Esmtra/The_CNC_pen_plotter/Report.pdf

# Cartesian Writing Robot

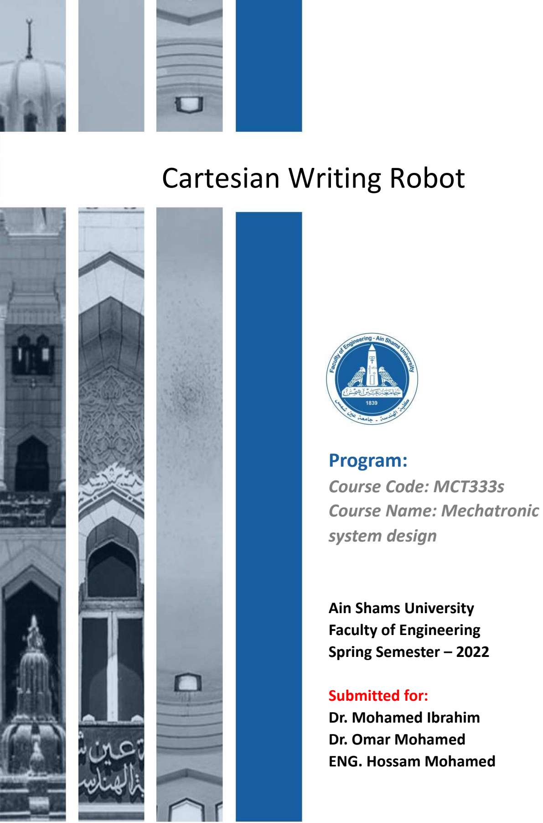
[picture p16: page 1]

SPRING SEMESTER - YEAR 2019/2020

# Program:

## Course Code: MCT333s Course Name: Mechatronic system design

## Ain Shams University Faculty of Engineering Spring Semester – 2022

## Submitted for: Dr. Mohamed Ibrahim Dr. Omar Mohamed ENG. Hossam Mohamed

2

AIN SHAMS UNIVERSITY
FACULTY OF ENGINEERING

MCT333, Mechatronics Design, FALL 2022

## Student Names:

Ashraf Mohamed AbdelSabor | 1802427
Eslam Sayed Rady | 1902236
Mohamed Hassan Mohamed | 1807742
Mohamed Hussein Adel | 1802683
Mohamed Ibrahim AbdelMoniem | 1808031
Walaa Hassan Mohamed | 1805008

3

# 1. Submission Contents

### 01: Introduction

### 02: Cad detailed design

### 03: MATLAB model and simulation

### 04: Actuator sizing

### 05: Electrical schematic and simulation

### 06: component selection

### 07: software design and framework

4

# Table of Contents

1.Table of contribution | Error! Bookmark not defined.
2.Submission Contents | 3
3.Abstract | 5
4..Intro to cartesian Robot: | 5
5.Cad detailed Design: | 7
6.MATLAB model and simulation: | 9
7.Actuator sizing by Simulink | 9
8.Actuator sizing: | 13
9.Electrical schematic and simulation: | 19
10.Component selection | 21
11.Software design and frame work | 26
12.Trials | 30

# Table of Figures

Figure 1Assembly | Error! Bookmark not defined.
Figure 2Assembly | Error! Bookmark not defined.
Figure 3Simulink simulation | Error! Bookmark not defined.
Figure 4x-axis | 9
Figure 5y-axis | 10
Figure 6z-axis | 10
Figure 7block diagram of Simulink | Error! Bookmark not defined.
Figure 8Parent Sheet | 19
Figure 9CNC Driver-X child sheet | Error! Bookmark not defined.
Figure 10Simulation | 20
Figure 11Simulation2 | Error! Bookmark not defined.
Figure 12Inkscape | 26
Figure 13UGS | Error! Bookmark not defined.
Figure 14Open loop | Error! Bookmark not defined.
Figure 15Closed Loop | Error! Bookmark not defined.
Figure 16First Trial | 30
Figure 17Second Trial | Error! Bookmark not defined.
Figure 17Second Trial | Error! Bookmark not defined.

5

# 2.Abstract

# The term “CNC” is a generic term which can be used to describe

many types of devices, this would include plotters, vinyl cutters,

# 3D printers, milling machines and others. CNC stands for Computer Numerically Controlled and basically means that the physical movements of the machine are controlled by instructions, such as co-ordinate positions that are generated using a computer

# 3. Intro to cartesian Robot:

# Cartesian coordinate geometry is an excellent method for mapping three-dimensional space in a simple, easy-to-understand numerical system. In the Cartesian system for three-dimensional space, there are three coordinate axes that are perpendicular to each other (orthogonal axes) and meet at the

origin.

The three axes are generally referred to as the x-axis, y-axis, and z-axis. Any point in three-dimensional space is represented by three numbers as (x, y, z). X represents the distance of the point from the origin along the x-axis, y is the distance from the origin along the y-axis, and z is the distance from the origin along the

z-axis.

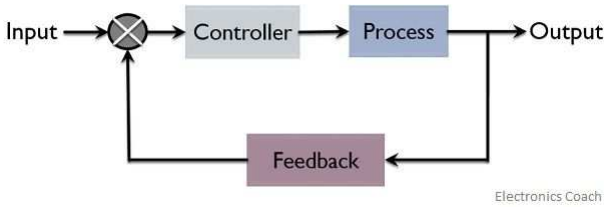
[picture p17: figure]

6

Cartesian robots have an overhead structure that controls the motion in the horizontal plane and a robotic arm that actuates motion vertically. They can be designed to move in x-y axes or x-y-z axes. The robotic arm is placed on the scaffolding and can be moved in the horizontal plane. The robotic arm has an effector or machine tool attached to the end of the arm which is a pen

# closed loop control system

# A closed loop control system is a mechanical or electronic device that automatically regulates a system to maintain a

desired state or set point without human interaction.

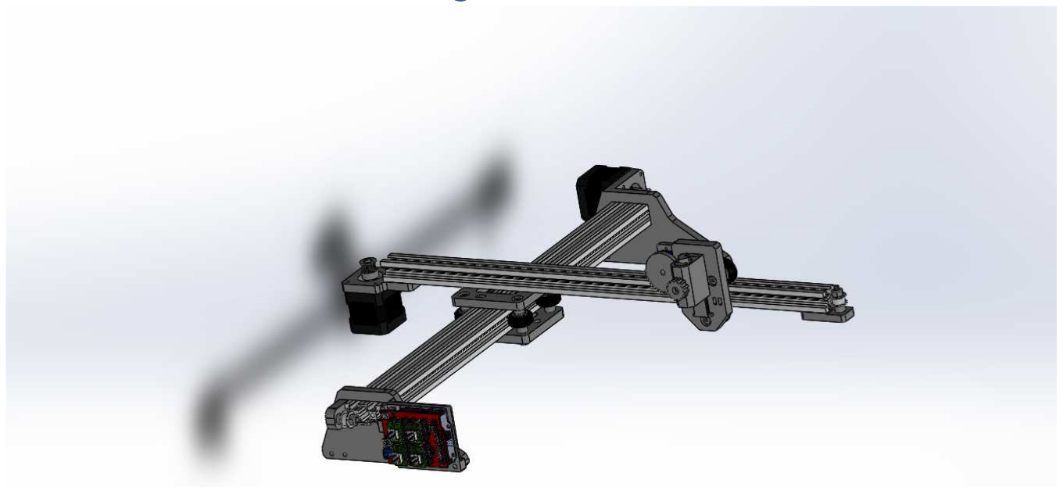
[picture p18: figure]

7

# 4. Cad detailed Design:

Figure 1Assembly

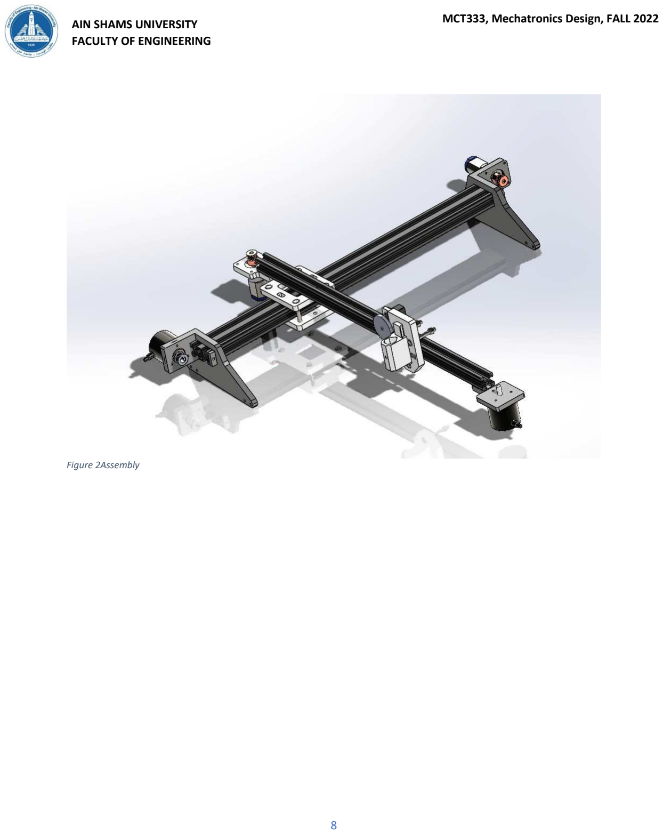
[picture p19: page 8]

8

Figure 2Assembly

# 5.MATLAB model and simulation:

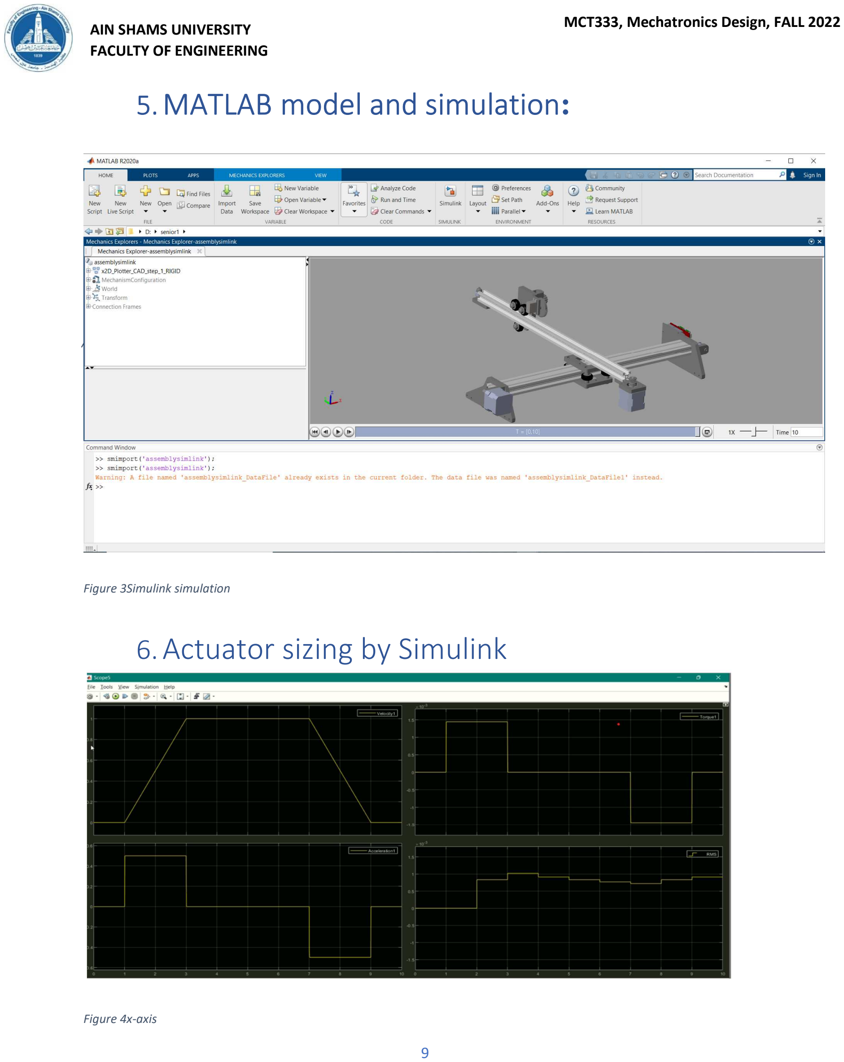
[picture p20: page 9]

9

Assembly2

# 6.Actuator sizing by Simulink

Figure 4x-axis

Figure 3Simulink simulation

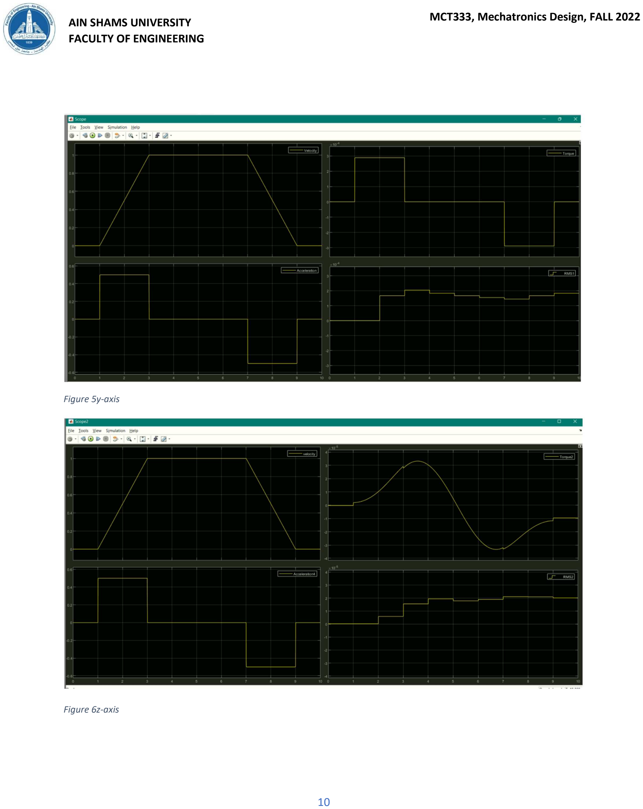
[picture p21: page 10]

10

Figure 5y-axis

Figure 6z-axis

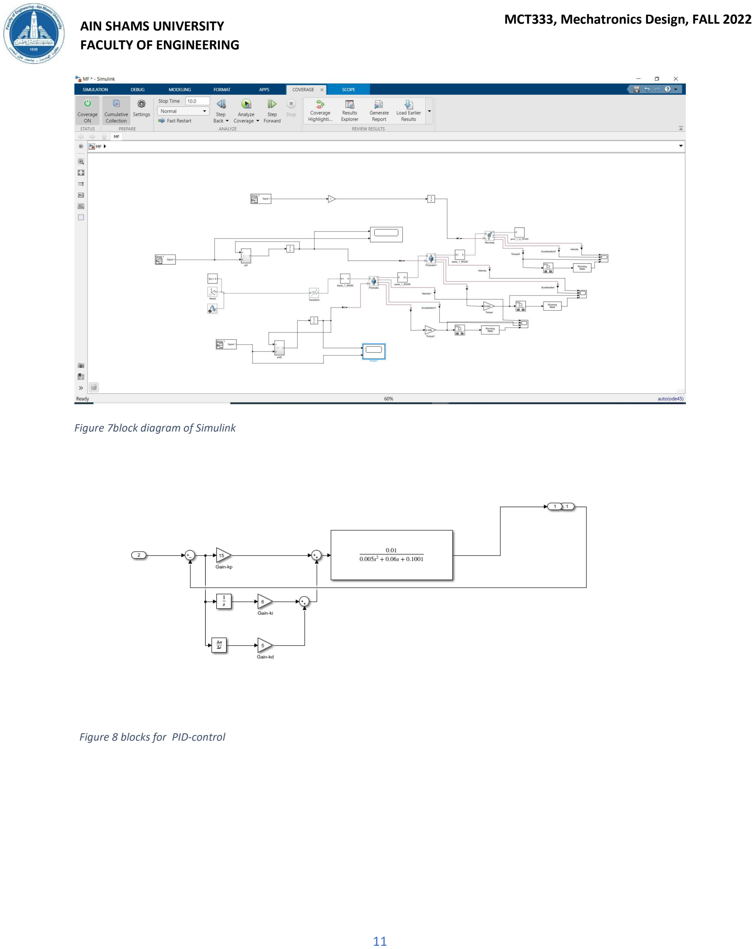
[picture p22: page 11]

11

Figure 8 blocks for PID-control

Figure 7block diagram of Simulink

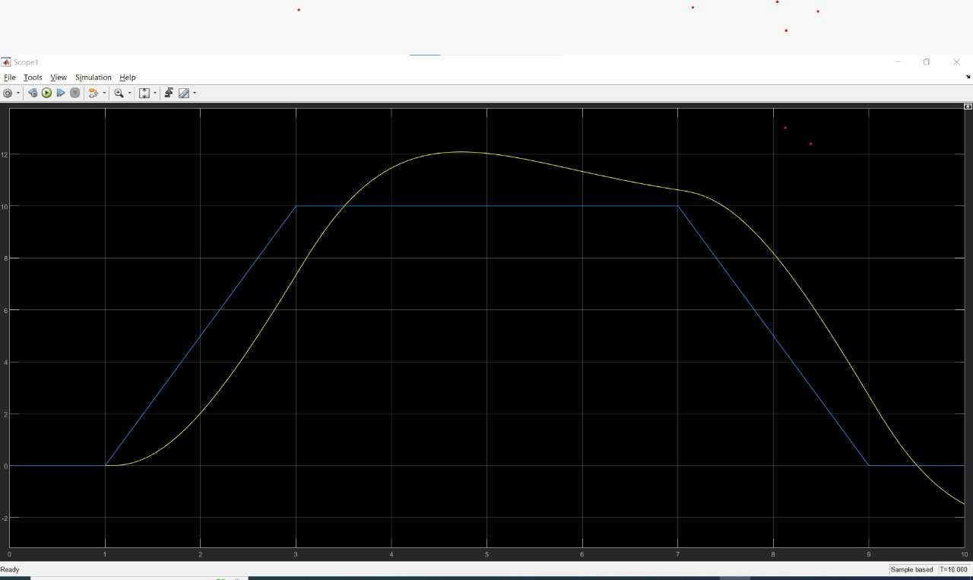
[picture p23: figure]

12

Figure 9 PID graph

13

# 8.Actuator sizing:

# Belt drive X

## For pully inertia:

d-

=

# = 14.11 mm = D

r =

5
2

= 2.5mm

# made of aluminum → ∴ ρ = 2700 !"

# Volume = V = %

&

# h (D − d

)
∴ V =

π
4

∗ (16 ∗ 10./0 ∗ 1(14.11 ∗ 10./0

− (5 ∗ 10./0

2

V = 2.188 *10.m/
→ m = ρ V = 2700 ∗ 2.188 *10. = 5.9 *10./ kg .

## Assume we neglect the mass of belt

∴ 3 =

1
2

4 5 =

1
2

∗ 5.9 ∗ 10./ ∗ 7 8

9:
2

;

+ 5=>>?@

A
= 0.5 ∗ 5.9 ∗ 10./ ∗ BC14.11 ∗ 10./ 2

D

+ (2.5 ∗ 10./0

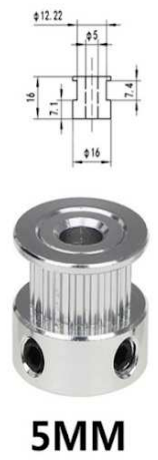
[picture p24: figure]

# E = 1.65 ∗ 10.FGH. 4 2 motors → I JKLLMNO , QRS OJMMS TQUVW = X ∴ VMYY. = I ∗ V = Z. Z[\ ∗ X[.] ^_. `I

# as V`WUWT =

X
X

# VMYY. = Z. Z[\ ∗ X[.] ^_. `I

## - For motor: Inertia is equal to 5.4 * 10.GH. 4

# 3abacd = 5.4 ∗ 10. + 3.305 ∗ 10.F = 5.73 ∗ 10.GH. 4

14

# fghgijkl = ∑ n → X

## *Assuming that writing Speed (end effector speed)

Let o:cp = 250 mm/s ,

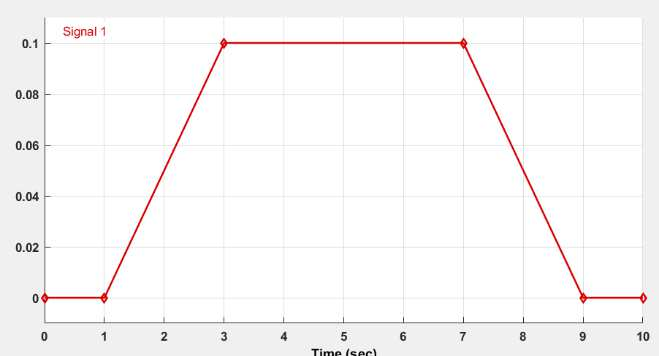
[picture p25: figure]

# ∴ qr:cp =

s
@

=

tu

= 40.916 5v9/x

## Assume that the height of a letter is 2 cm

## and max Velocity is 200 mm/s ∴ the time could be taken = ∗ uyz

u.t
= 0.08 s

# Assume → {c = {@ = {| = 0.08 x

∴ ql =

# ~rÄÅ

a

= 511.45 5v9/x

# ÇÉ@=Ña=b> = ÖÉ@=Ña=b> ∗ 5 = Ü4H ∗ 5 =0.00578 Nm

## From (1) → Ç: − ÇÉ@=Ña=b> = ( 3abacd.0 ∗ ql =0.00293

# ∴ Ç: = 8.71 ∗ 10./ N.m Ç@:á = à

â ä

z

(a0 |a

# ãåçåéè

ê

# äåçåéè

=1.77 ∗ 10./ N.m

# Çc = 0.00871N.m

Ç@ = 0.00578 ë. 4

## Ç| =0.00285 N.m

# Ç:bab@

t

8.71

5.78

2.85

15

# Belt drive Y

# For pully inertia:

# In (Y)

d-

=

# = 14.11 mm = D

r =

5
2

= 2.5mm

# made of aluminum → ∴ ρ = 2700 !"

# Volume = V = %

&

# h (D − d

)
∴ V =

π
4

∗ (16 ∗ 10./0 ∗ 1(14.11 ∗ 10./0 − (5 ∗ 10./0

2

V = 2.188 *10.m/
→ m = ρ V = 2700 ∗ 2.188 *10. = 5.9 *10./ kg .

## Assume we neglect the mass of belt

∴ 3 =

1
2

4 5 =

1
2

∗ 5.9 ∗ 10./ ∗ 7 89:
2

;

+ 5=>>?@

A
= 0.5 ∗ 5.9 ∗ 10./ ∗ BC

14.11 ∗ 10./
2

D

+ (2.5 ∗ 10./0

E

# = 1.65 ∗ 10.FGH. 4 2 motors → 2 íìîîïñx , vó9 xíïï9 5v{3ò = 1 ∴ 3?ÉÉ. = 2 ∗ 3 = 3.305 ∗ 10.F GH. 4

1
2

4ô =

1
2

# 3?ÉÉö

# →∴ 3?ÉÉ = 45 = 9.557 ∗ 10.GH. 4

16

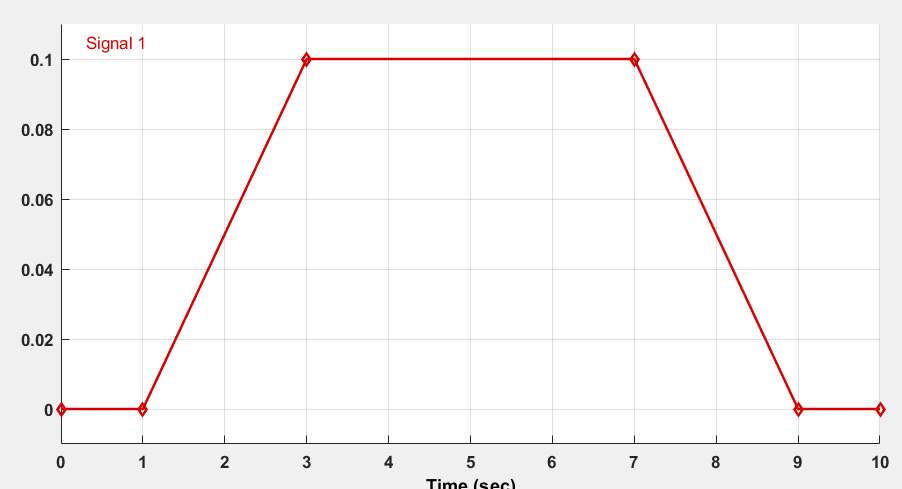
[picture p26: figure]

t

# as 3:bab@ =

# (3.305 ∗ 10.F + 9.557 ∗ 10.0 = 9.887 ∗ 10. GH. 4

## - For motor: Inertia is equal to 5.4 * 10.GH. 4

# 3abacd = 5.4 ∗ 10. + 9.887 ∗ 10. = 1.5 ∗ 10.tGH. 4 iõúõùûθl = ∑ T → 1

## *Assuming that writing Speed (end effector speed)

Let o:cp = 250 mm/s ,

# ∴ qr:cp =

s
@

=

tu

= 40.916 5v9/x

## Assume that the height of a letter is 2 cm

## and max Velocity is 200 mm/s ∴ the time could be taken = ∗ uyz

u.t
= 0.08 s

# Assume → {c = {@ = {| = 0.08 x

∴ ql =

# ~rÄÅ

a

= 511.45 5v9/x

# ÇÉ@=Ña=b> = ÖÉ@=Ña=b> ∗ 5 = Ü4H ∗ 5 =0.00578 Nm

# Ç° = Ö° ∗ 5 = 0.00936 ë. 4

# From (1) → Ç: − ÇÉ@=Ña=b> − Ç° = ( 3abacd.0 ∗ ql =0.00293

# ∴ Ç: = 0.0116 N.m Çc = 0.0116N.m

Ç@ = 0.01807 ë. 4

## Ç| =0.0122 N.m

# Ç:bab@

0.0116

0.0180

0.0122

17

# Rack and Pinion:

# ¢?ÉÉö:

=

¢£.ö:

+

4ô@
¢?ÉÉ =

§•.
¶z +

:ßz
¶z

# 5v®G vó9 í3ó3òó ℎvx xv4ï í5ò™3îï → ∴ ë = ¶´

¶z

= 1
¢£ =

45 = 0.5 ∗ 0.008 ∗ (2.4 ∗ 10./0 = 2.3 ∗ 10.¨GH. 4

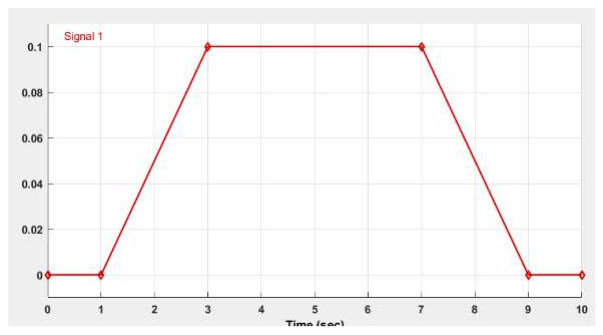
[picture p27: figure]

∴

:ßz
¶z =

# u.ut/∗.&∗uy#Æ

z

= 3.053 ∗ 10.F

# ∴ ¢?ÉÉ = 3.28 ∗ 10.FGH. 4 vxxì4ï

§

# §èØØ

# = 1 ∴ ¢abacd = 6.566 ∗ 10.F GH. 4

## Finding max. speed

# assume {c = {@ = {| = 30 4x

## Assume qabacd = °

# qabacd = q:cp

r ±

# aÄa²a³

¥

# ∴ q:cp

# r = 52.35 5v9/ sec

qc

l =
~ÄÅ

r
aÄ

=

t./t

# /u∗uy# = 1745 5v9/xï®

q@

# l = 0 , q| l =

.~ÄÅ

r
a³

# = −1745 5v9/xï® ∴ Ç:i = ¢abacd ∗ q l = 6.566 ∗ 10.F ∗ 1745 = 1.148 ∗ 10./ ∴ Ç:| = ¢abacd ∗ q l = 6.566 ∗ 10.F ∗ 1745 = −1.148 ∗ 10./

∴ Ç: = 0.0146 ∗ 1.25 = 0.0186 ë. 4

# Ç:bab@

t

1.148

-1.148

18

Ç@:á
= à

(0.01480

∗ 30 ∗ 10./ + (−0.01480
∗ 30 ∗ 10./

# 150 ∗ 10./ vxxì4ï {|°

= 60 4x

# Ç@:á = 0.0094 ë4 ∗ 1.25 = 0.0118

# 9.Electrical schematic and simulation:

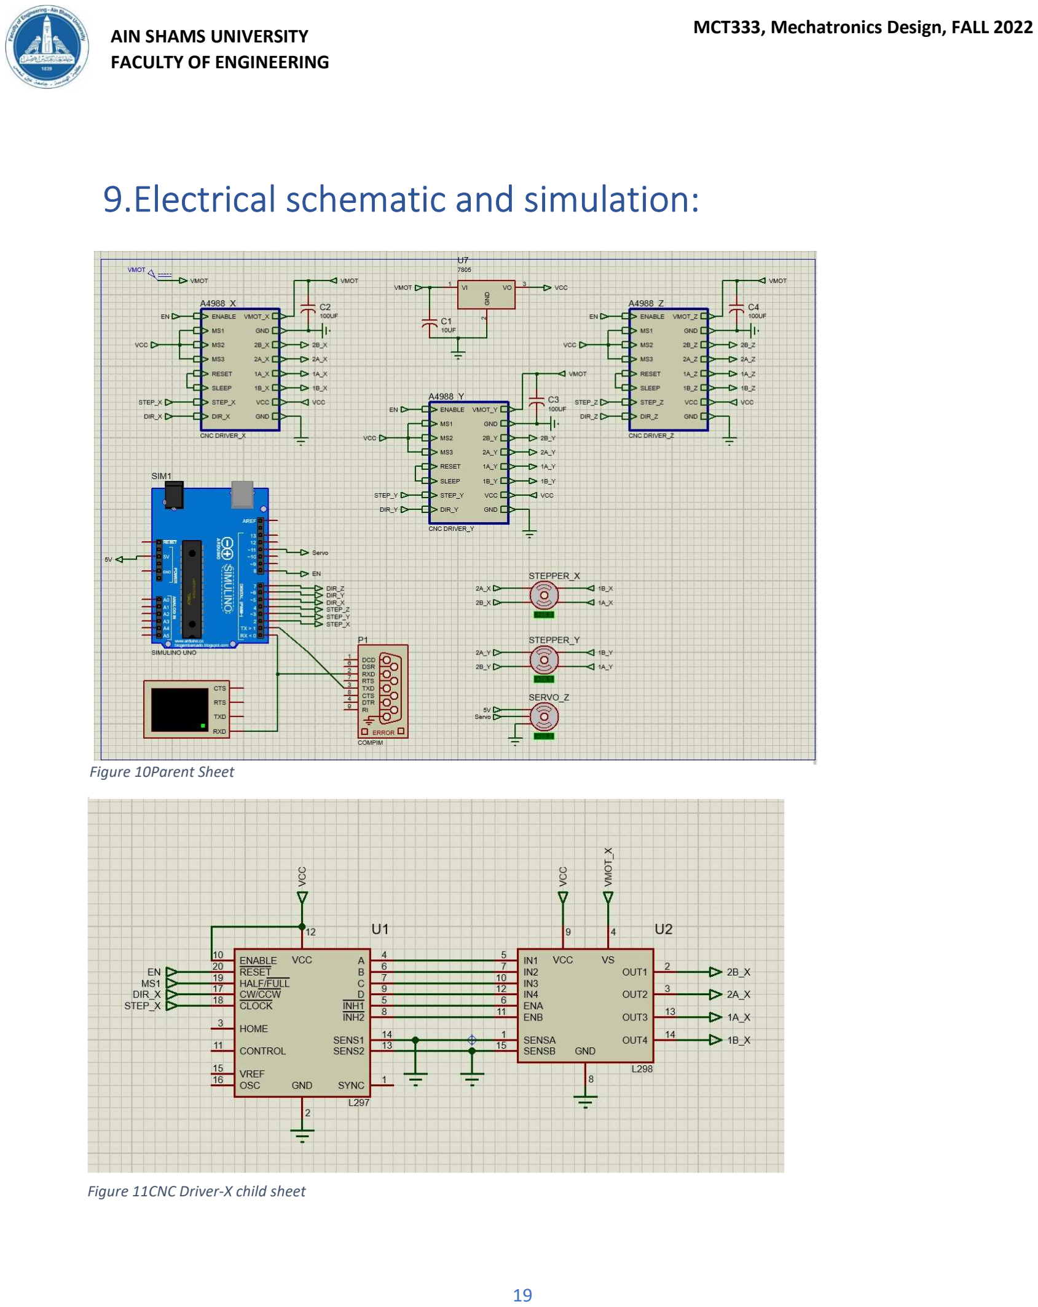
[picture p28: page 19]

19

Figure 10Parent Sheet

Figure 11CNC Driver-X child sheet

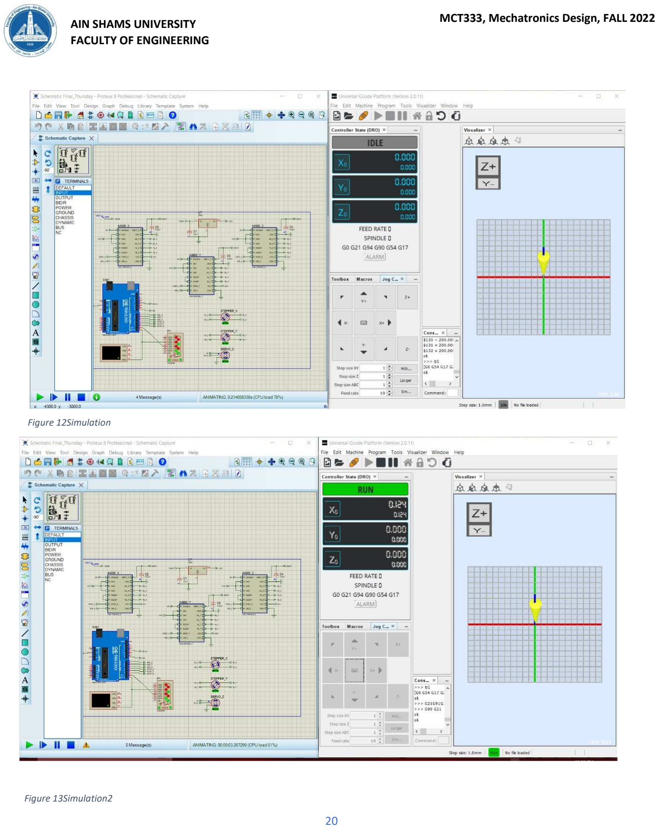
[picture p29: page 20]

20

Figure 12Simulation

Figure 13Simulation2

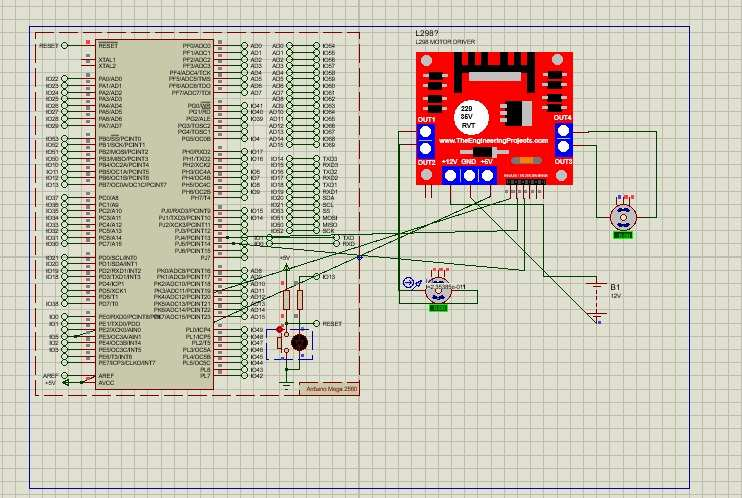
[picture p30: figure]

21

# 10.Component selection

components | Reason for selection | Specification

22

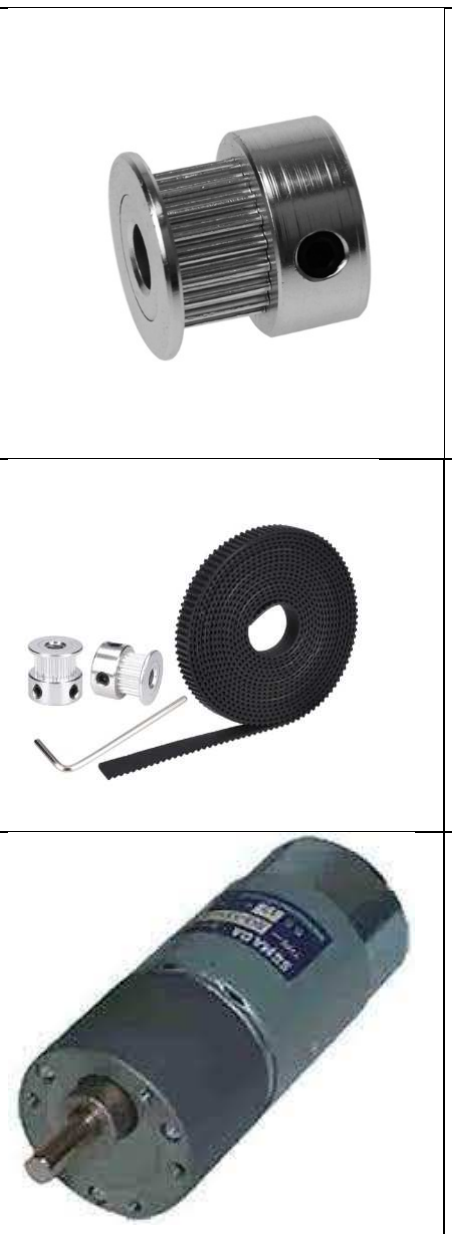
[picture p31: figure]

GT2 Bore 5mm 20 Teeth Timing Aluminum Pulley Fit GT2-6mm Open Timing Belt | Changing the direction of forces and easy to moving slider by using belt | • Color: silver • Tooth number: 20 • Tooth pitch: 2mm • Bore diameter: 5mm • Flange: double • Tooth width: 7mm ( Very Suitable and good for 6mm synchronous belt )
Meters GT2-6mm Open Timing Belt | Translate rotational motion of stepper to linear motion by cart | • Color: black • Pitch: 2mm • Width: 6mm • Material: fiber reinforced rubber
DC Geared Motor 50r/min , 0.62 N.m 2.9 Watt | geared DC Motor has a gear assembly attached to the motor. The speed of motor is counted in terms of rotations of the shaft per minute and is termed as RPM . The gear assembly helps in increasing the torque and reducing the speed | Rated Voltage: 12Vdc No Load Current: 140mA No Load Speed: 50 r/min Load Torque Current (With Load): 800mA Load Torque Speed (With Load): 36 r/min Torque: 6.3 Kgf.cm (0.62 N.m) Output Power: 2.3 W Stall Current: 3000mA Motor Weight: 350~400 gm
C-Beam Linear Rail | C-Beam linear rail is the ultimate solution combining both linear motion and a modular, structural framing system. It's lightweight yet rigid and provides an smooth track for precise motion. It is compatible with all out standard V-slot parts and accessories. | Material: 6063 T-5 Aluminum.

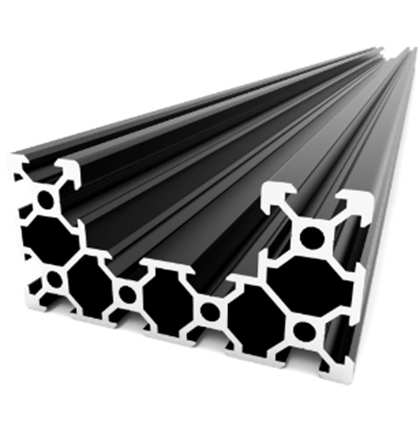
[picture p32: figure]

23

3d printing parts | Provide housing for the robot | Material: PLA Density 1.2g/cm2 Fillin: 50%

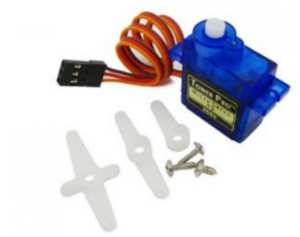
[picture p33: figure]

Servo motor | Hold pin and give direction in z axis

24

Metal V-Groove Bearing Kit | These are specialized metal bearings that are used in linear motion systems. The v-groove bearings generally ride on our rail | (2) Ball Bearings - 625 2RS (1) OpenBuilds Dual V Wheel - Metal (5mm Bore) (1) 5mm Precision Shim (1) 1/4" Aluminum Spacer (1) M5 * 25mm Low Profile Screw (1) Lock Nut with Nylon Insert
DC motor shield | the L293D is a dual-channel H-Bridge motor driver capable of driving a pair of DC motors or single stepper motor. As the shield comes with two L293D motor driver chipsets, that means it can individually drive up to four DC motors making it ideal for building four-wheel robot platforms | HiLetgo L293D DC Motor Drive Shield Stepper Motor Drive Shield Expansion Board for Arduino Duemilanove Raspberry Pi

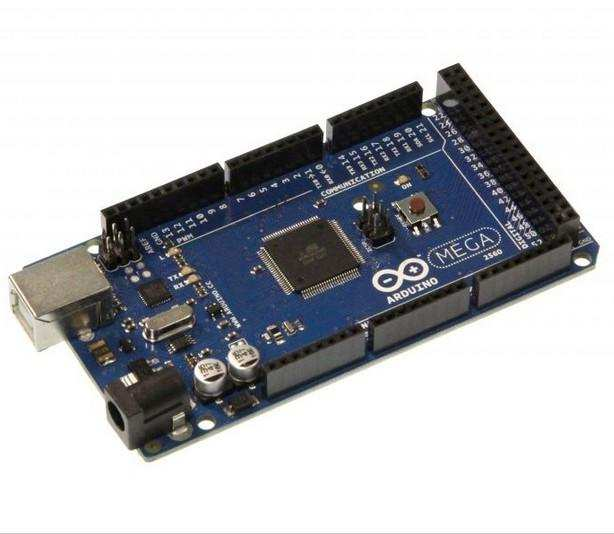
[picture p34: figure]

## Arduino

The Arduino Mega is a
microcontroller board based on the ATmega2560. It has
54 digital input/output pins (of which 15 can be used as PWM outputs), 16 analog
inputs, 4 UARTs (hardware
serial ports), a 16 MHz
crystal oscillator, a USB
connection, a power jack, an ICSP header, and a reset
button. It contains
everything needed to
support the microcontroller; simply connect it to a
computer with a USB cable
or power it with a AC-to-DC adapter or battery to get started.

## Arduino mega

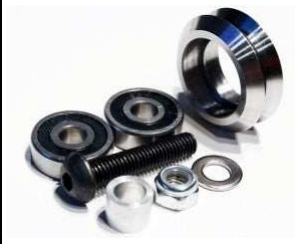
[picture p35: figure]
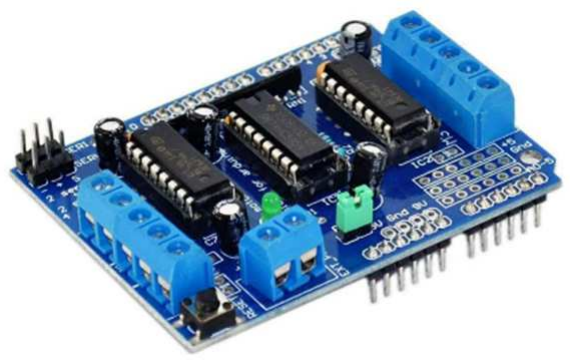
[picture p36: figure]

25

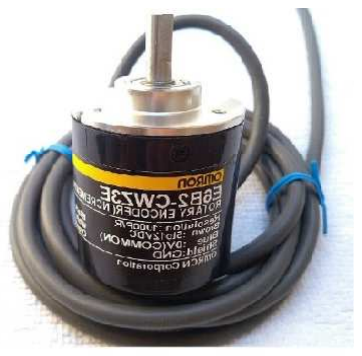
[picture p37: figure]

## Encoder

## an encoder is a sensing device that provides feedback. Encoders convert motion to an electrical signal that can be read by some type of control device in a

motion control system.

## The encoder sends a feedback signal that can be used to determine

position, count, speed,

## or direction. A control device can use this information to send a command for a

particular function.

## Rotary Encoder E6B2-CWZ3E (1000 P/R)

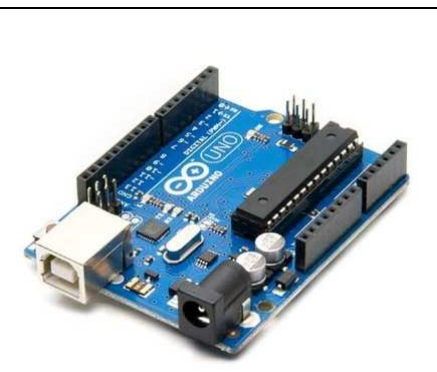
[picture p38: figure]

Arduino | Arduino is an open source hardware and software c ompany, project, and user community that designs and manufactures single board microcontrollers and mi crocontroller kits for building digital devices. | UNO

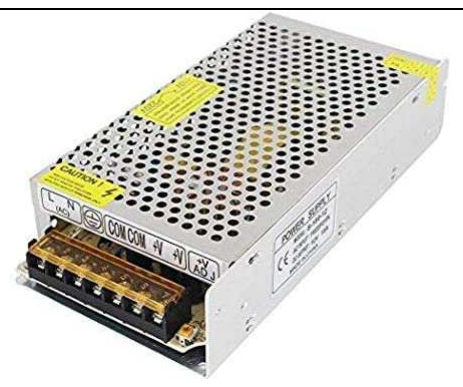
[picture p39: figure]

Power supply | power supply is an electronic circuit that converts the voltage of an alternating current (AC) into a direct current (DC) voltage. It is basically consisting of the following elements: transformer, rectifier, filter and regulator circuits. | 12 V , 5 A

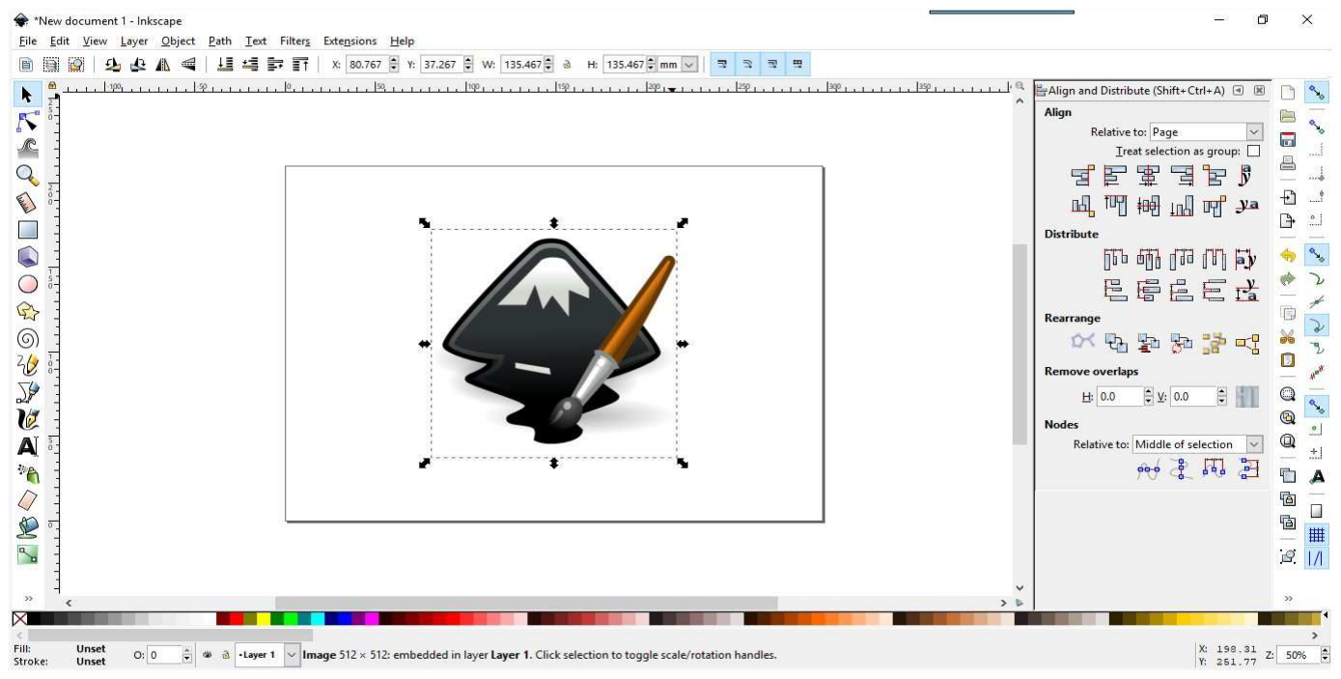
[picture p40: figure]

26

# 11.Software design and frame work

# First: Open loop

# In this project we will use 3 main open sources software programs:

# 1)Inkscape: it’s our HMI. used to convert the image needed to be drawn into path and then creates GCODE file to be sent to

Arduino.

Figure 14Inkscape

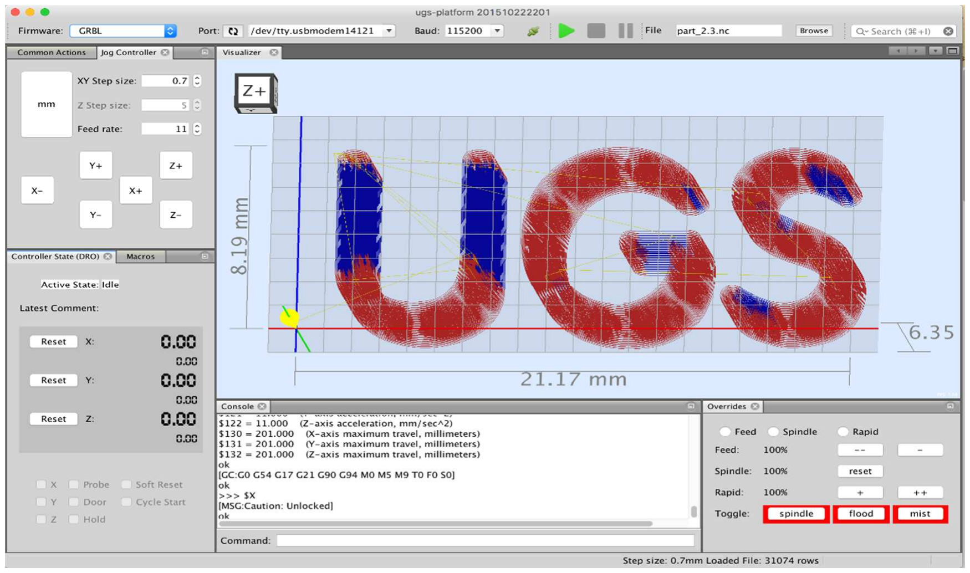
[picture p41: figure]

27

## Universal G-code sender (UGS): it’s the communication

# between our machine and computer, it has advantages of like more oversight of the machine and a real time view of the

toolpath.

# 2) GRBL: it’s the main software running on Arduino that converts

G-code into electrical signals to motor drivers (CNC shield).

## Run GRBL on Arduino:

## download the GRBL library and extract it in the Arduino's library folder. now open Arduino ide and open GRBLMAIN in example sketches, and upload "GRBL to Arduino Sketch" to your Arduino UNO board. and that's it. you have uploaded GRBL to your Arduino board

Figure 15UGS

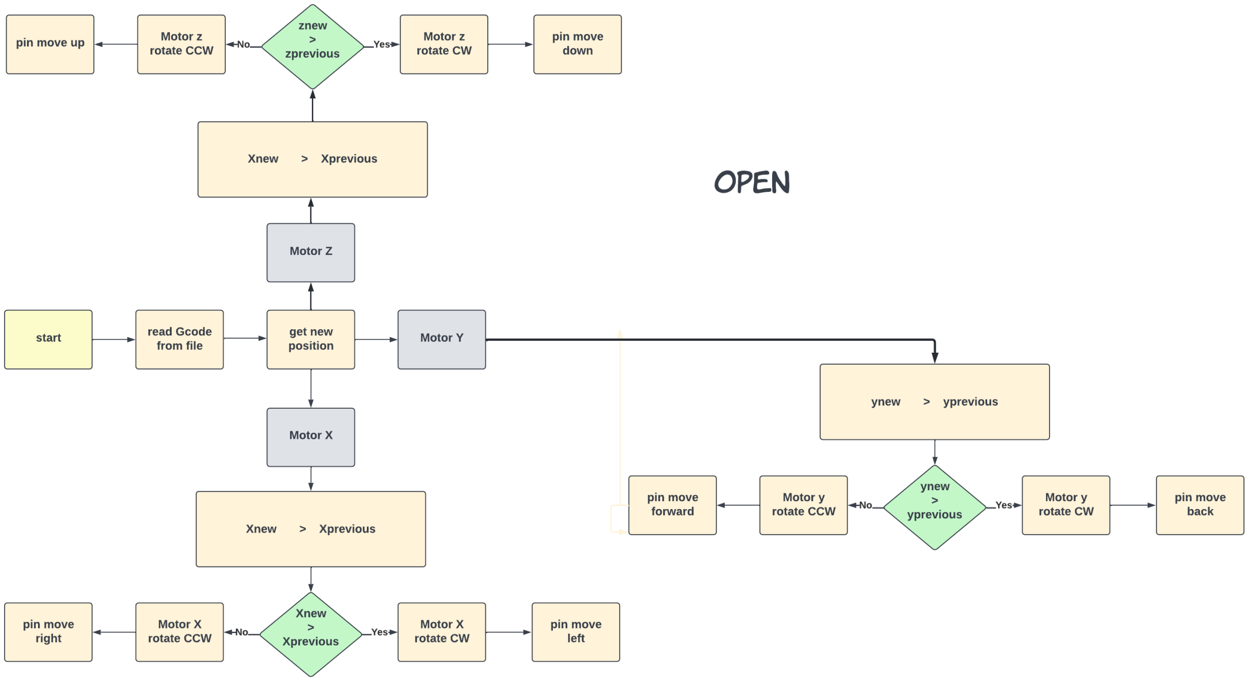
[picture p42: figure]

28

# 3)GRBL-Plotter

GRBL-Plotter is a graphic converter and gcode sender for all purposes.

## The main focus is on the post-processing of vector graphics, the specialty is the preparation of the generated Gcode, which is based on properties of the imported graphics, such as Layer, pen color or pen thickness

# Flowchart for open loop

Figure 16Open loop

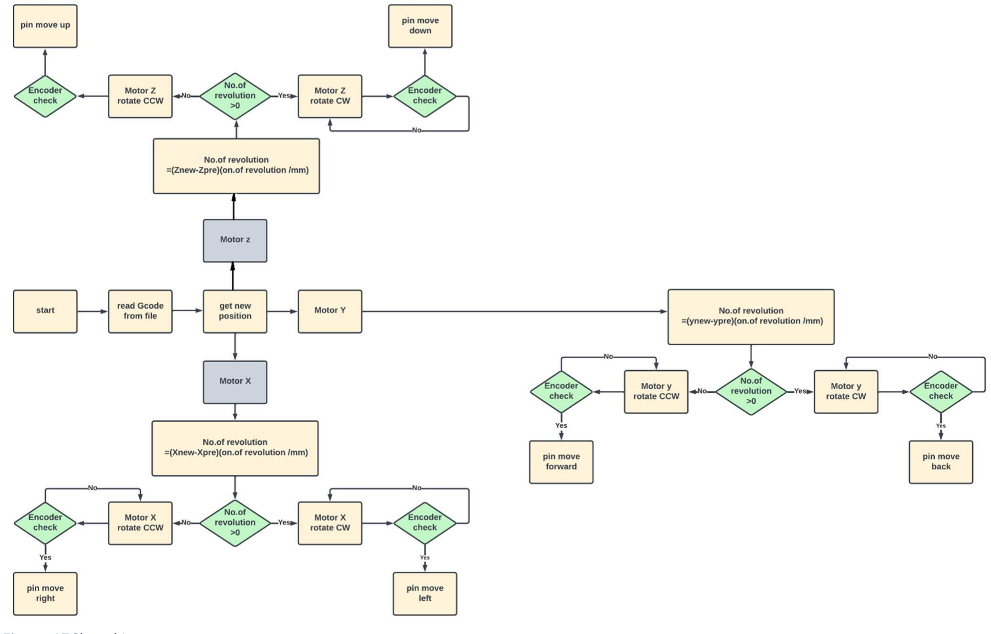
[picture p43: figure]

29

# Second: closed loop

in closed loop we will control dc motors using PID and encoders,

# so we will use only Inkscape to get GCODE from, and universal G-code sender to send to Arduino. then we code Arduino file and

make it reads the new position of each axis from this G-code file,

# then calculate the number of Rotation needed to be rotated by each

# axis from this equation ·>?° − ·£@?Æ ¸ (óì4¹ï5 ò™ 5ò{v{3òó /

440

# Flowchart for closed loop

Figure 17Closed Loop

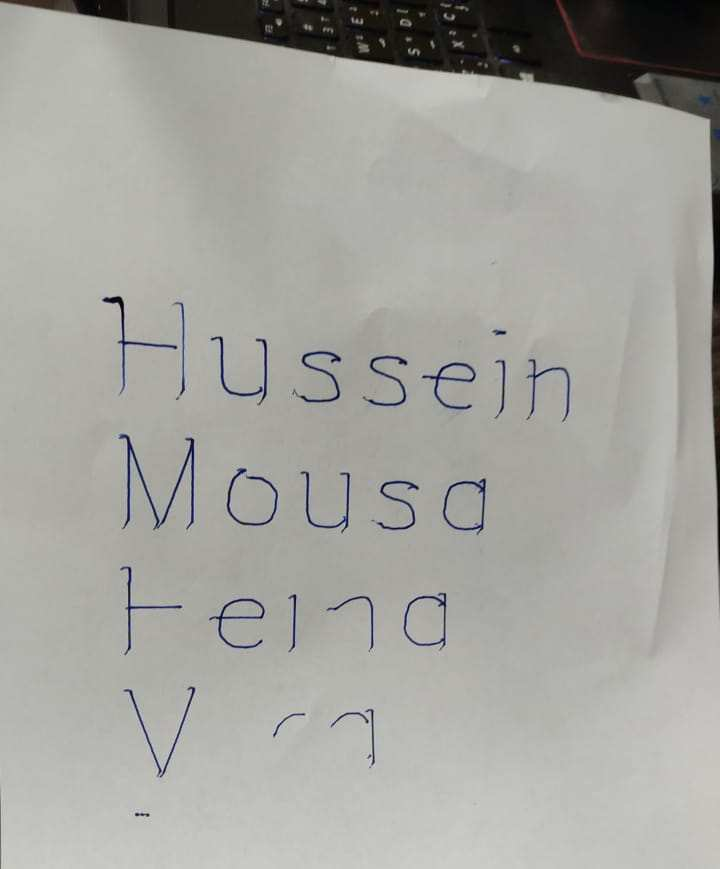
[picture p44: figure]

30

# 12.Trials

Figure 18First Trial

## Servo doesn’t work

## Reason: because Pinion broken

## Solution: we printed Pinion

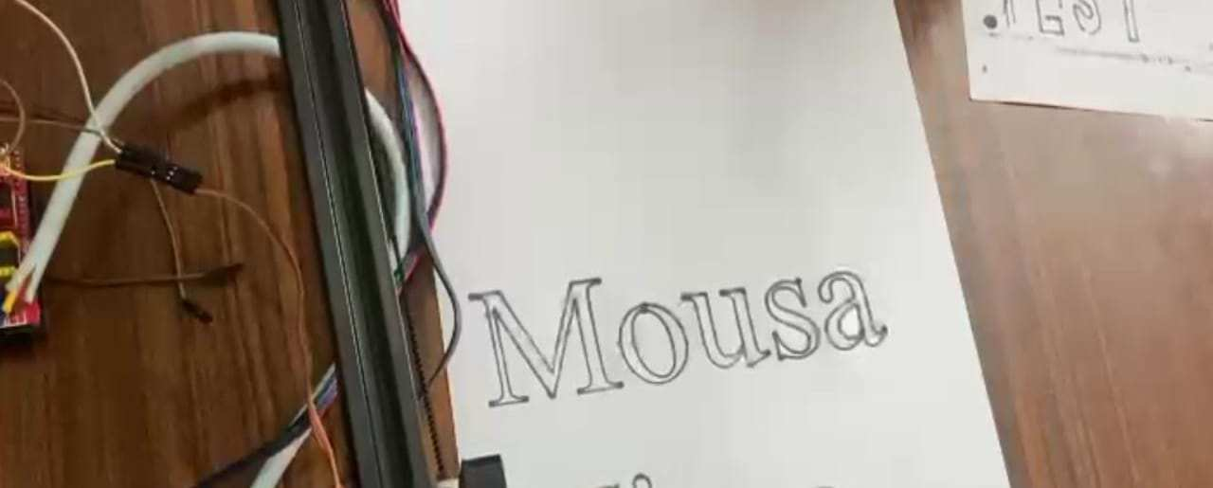
[picture p45: figure]

31

Figure17Second Trial

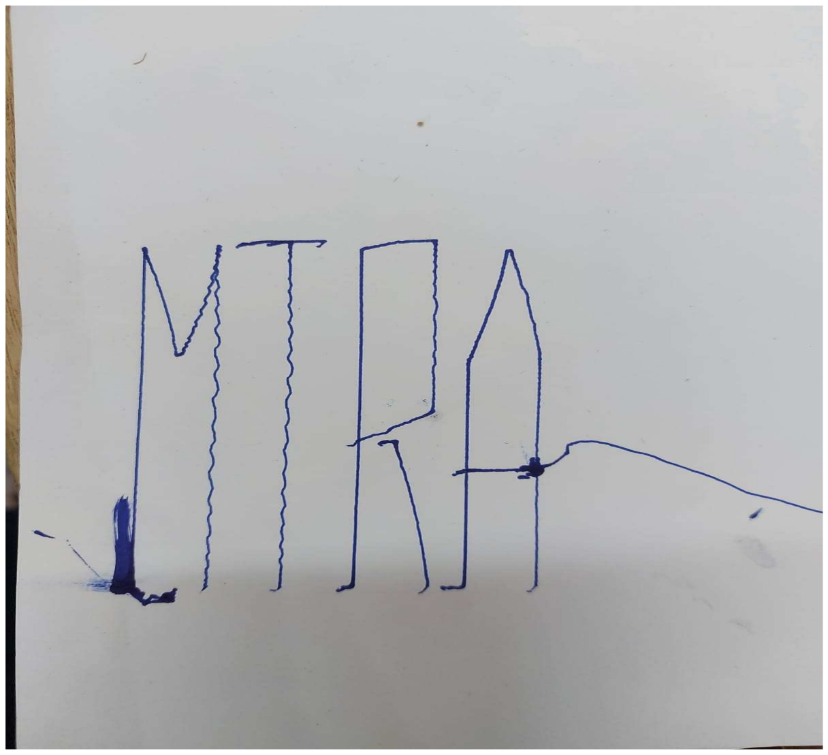
[picture p46: figure]

32

# Closed loop trail
