Esmtra/The_CNC_pen_plotter/Img/Driver-X child shee2t.jpg

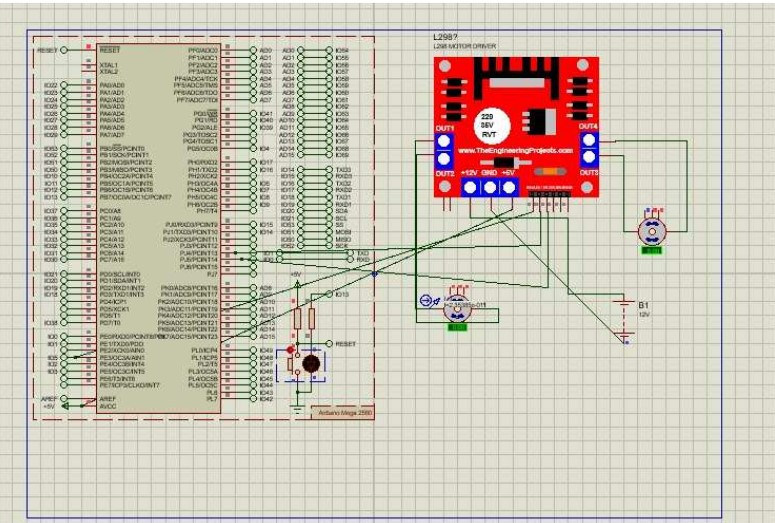
Img/Driver-X child shee2t.jpg
