Esmtra/The_CNC_pen_plotter/Img/Driver-X child sheet.jpg

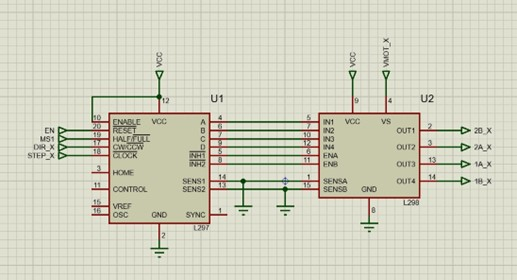
Img/Driver-X child sheet.jpg
